JoHassel/Exo_UI/3D/Bilder/Explosionsansicht_MainUI.png

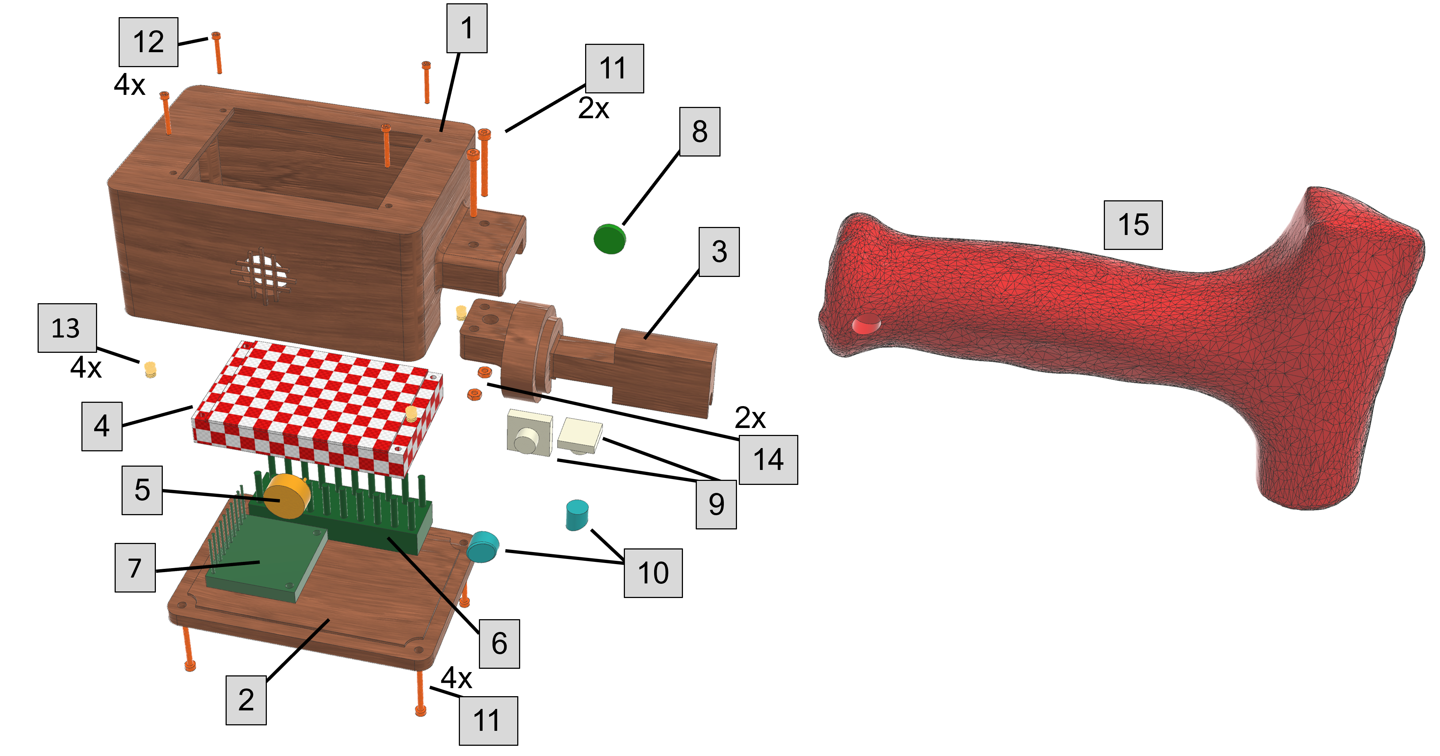
3D/Bilder/Explosionsansicht_MainUI.png
