JoHassel/Exo_UI/3D/Bilder/Konstruktion_real.jpeg

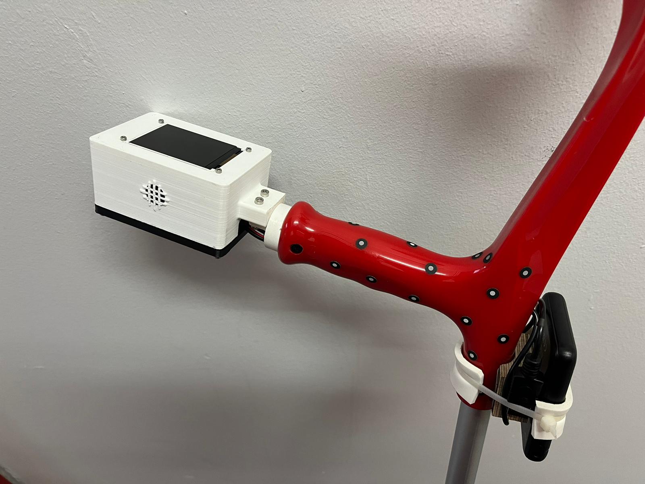
3D/Bilder/Konstruktion_real.jpeg
