JoHassel/Exo_UI/3D/Bilder/Kruecke_Hohlraum.jpeg

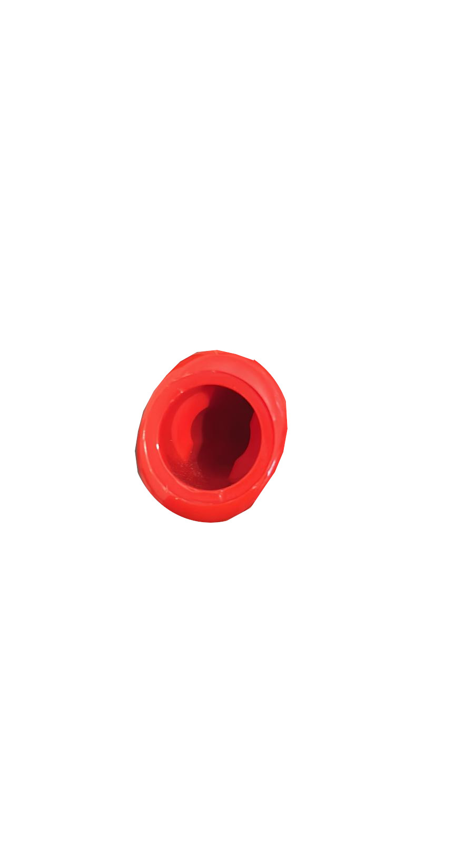
3D/Bilder/Kruecke_Hohlraum.jpeg
