JoHassel/Exo_UI/3D/Bilder/MainUI_Explosion.tif

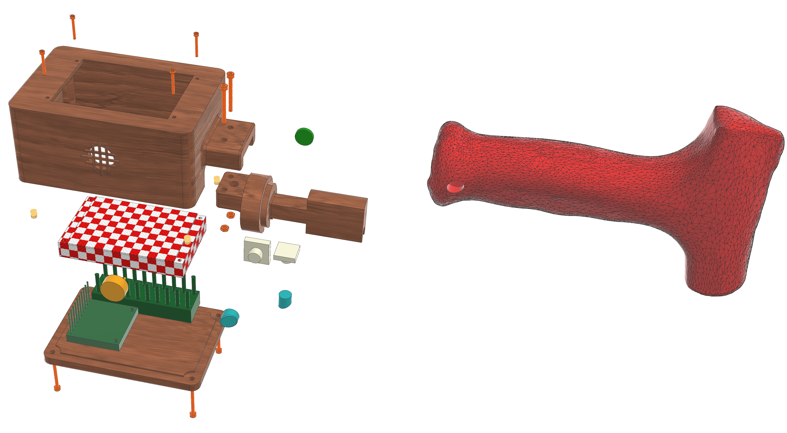
3D/Bilder/MainUI_Explosion.tif
