JoHassel/Exo_UI/3D/Bilder/MainUI_iso.png

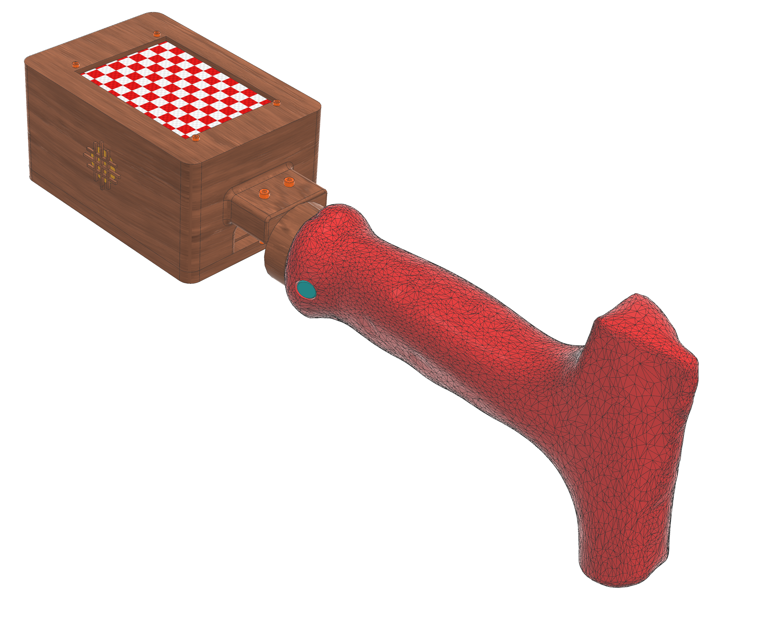
3D/Bilder/MainUI_iso.png
