JoHassel/Exo_UI/3D/Bilder/MainUI_Querschnitt.tif

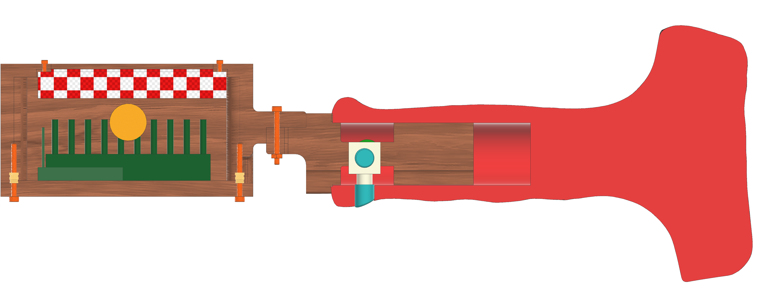
3D/Bilder/MainUI_Querschnitt.tif
