JoHassel/Exo_UI/3D/Bilder/SACU_Explosion.tif

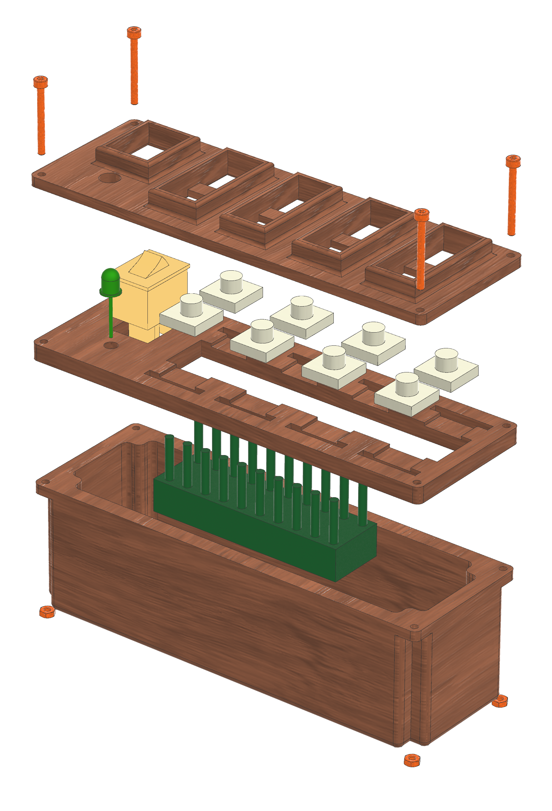
3D/Bilder/SACU_Explosion.tif
