JoHassel/Exo_UI/3D/Bilder/SACU_iso.tif

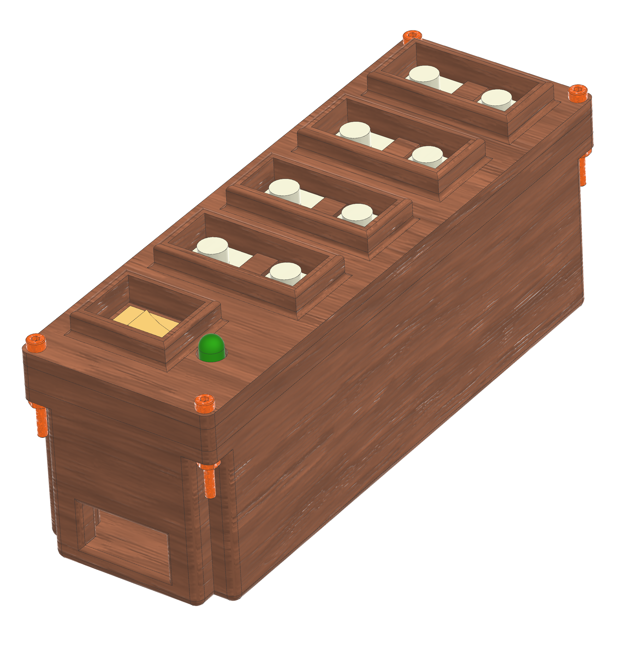
3D/Bilder/SACU_iso.tif
