JoHassel/Exo_UI/3D/Bilder/SACU_Querschnitt.tif

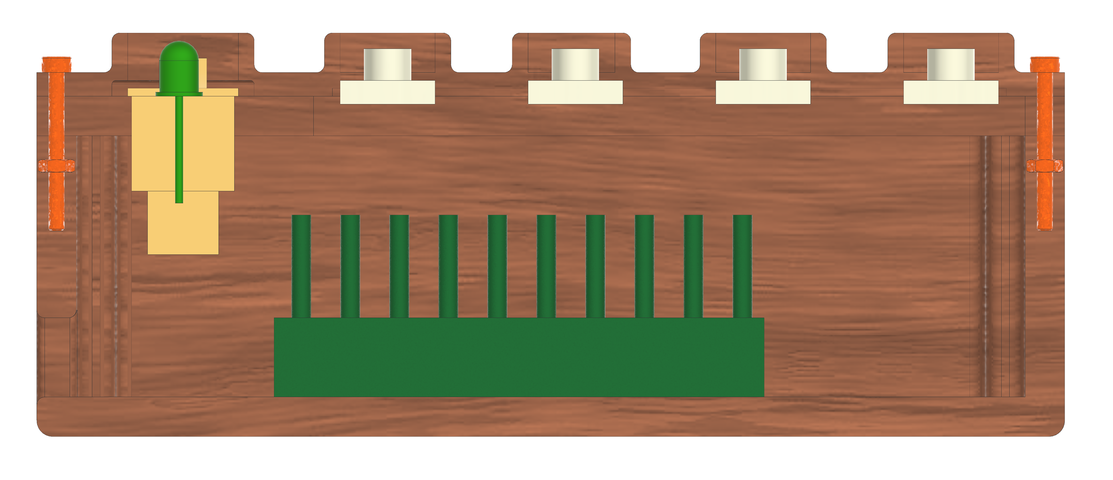
3D/Bilder/SACU_Querschnitt.tif
