JoHassel/Exo_UI/Code/Flow_Chart/PAP_MainUI_Aktiver_Status.png

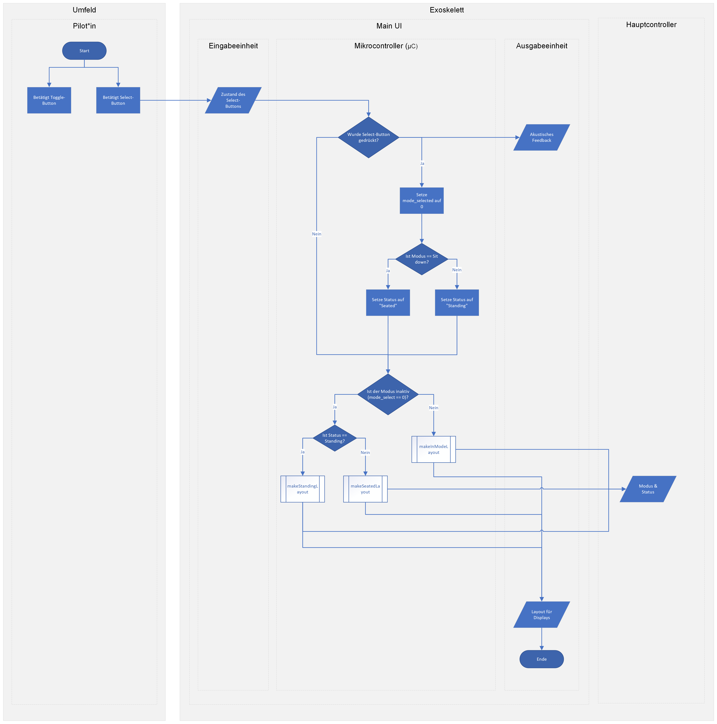
Code/Flow_Chart/PAP_MainUI_Aktiver_Status.png
