JoHassel/Exo_UI/Code/Flow_Chart/PAP_MainUI_Seated_Status.png

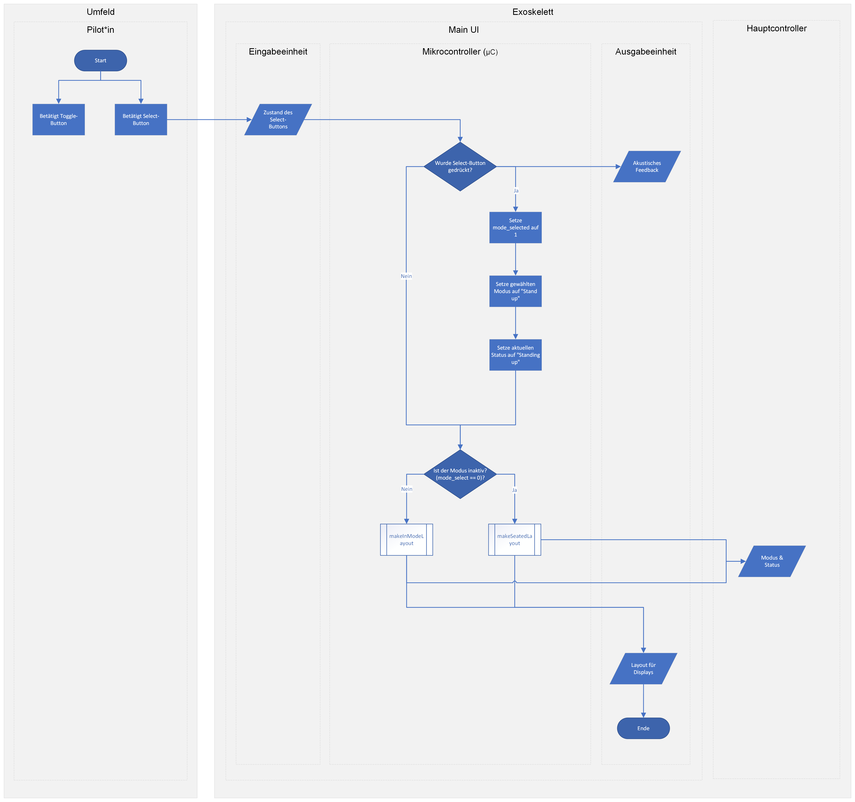
Code/Flow_Chart/PAP_MainUI_Seated_Status.png
