JoHassel/Exo_UI/Code/Flow_Chart/PAP_MainUI_Standing_Status.png

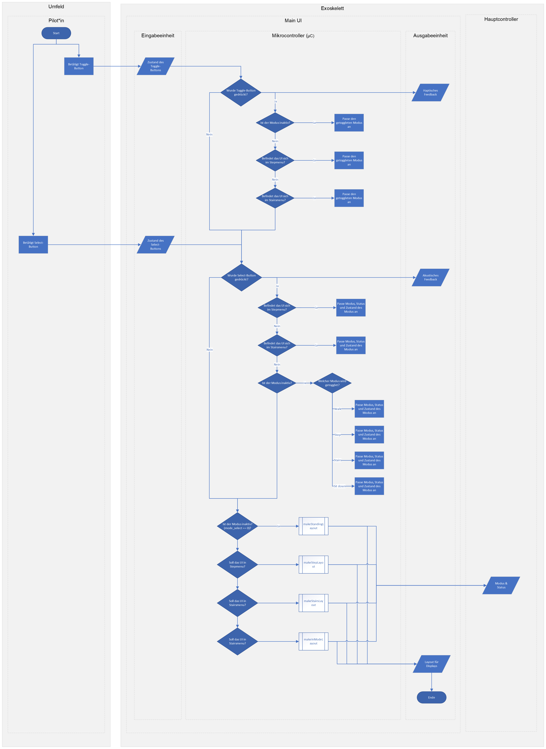
Code/Flow_Chart/PAP_MainUI_Standing_Status.png
