JoHassel/Exo_UI/Code/Flow_Chart/PAP_MainUI_Start.png

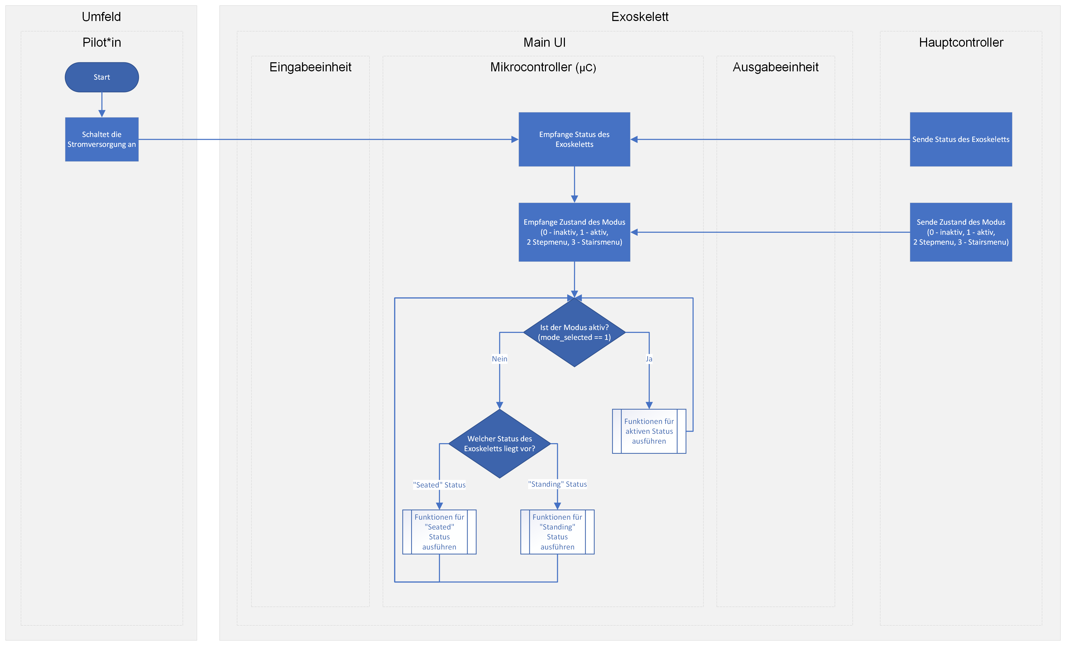
Code/Flow_Chart/PAP_MainUI_Start.png
