JoHassel/Exo_UI/Code/Flow_Chart/PAP_SACU.png

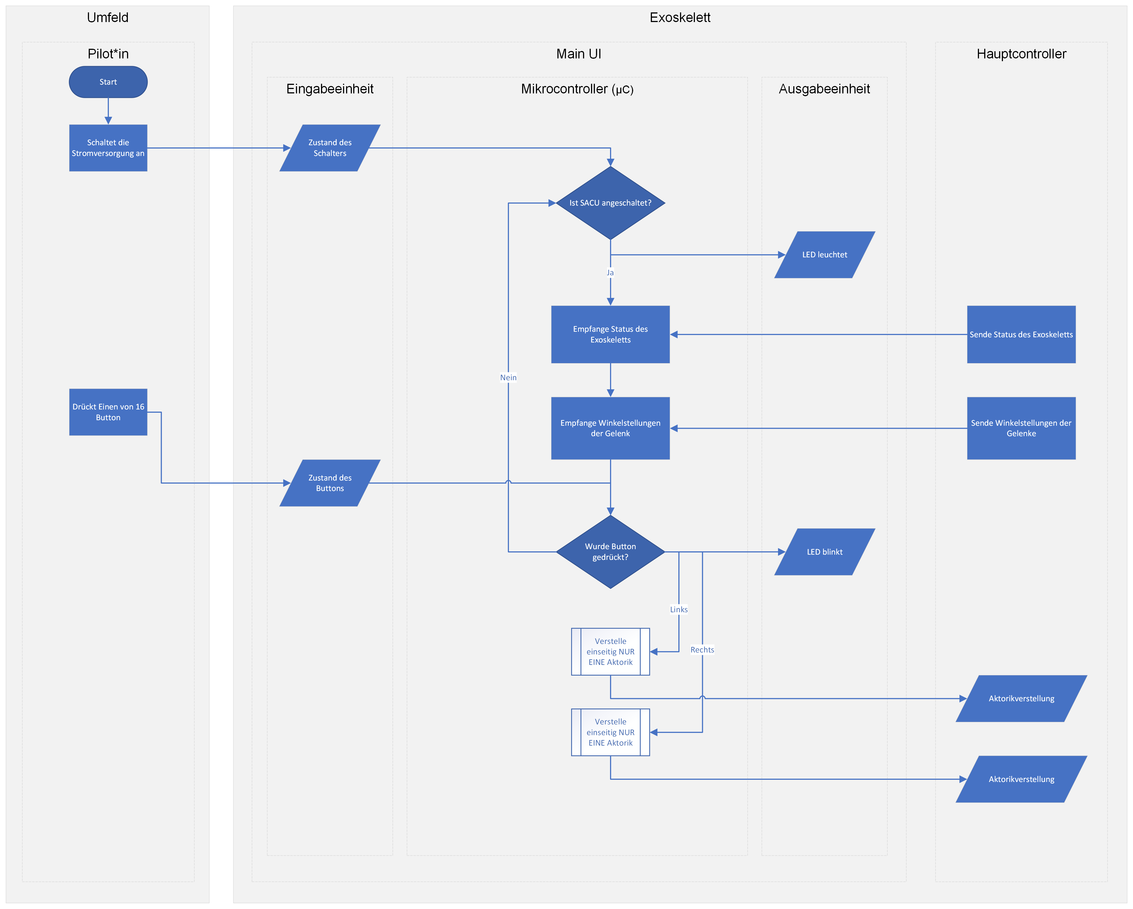
Code/Flow_Chart/PAP_SACU.png
