JoHassel/Exo_UI/EDA/Schaltplan_MAIN_UI_final.PNG

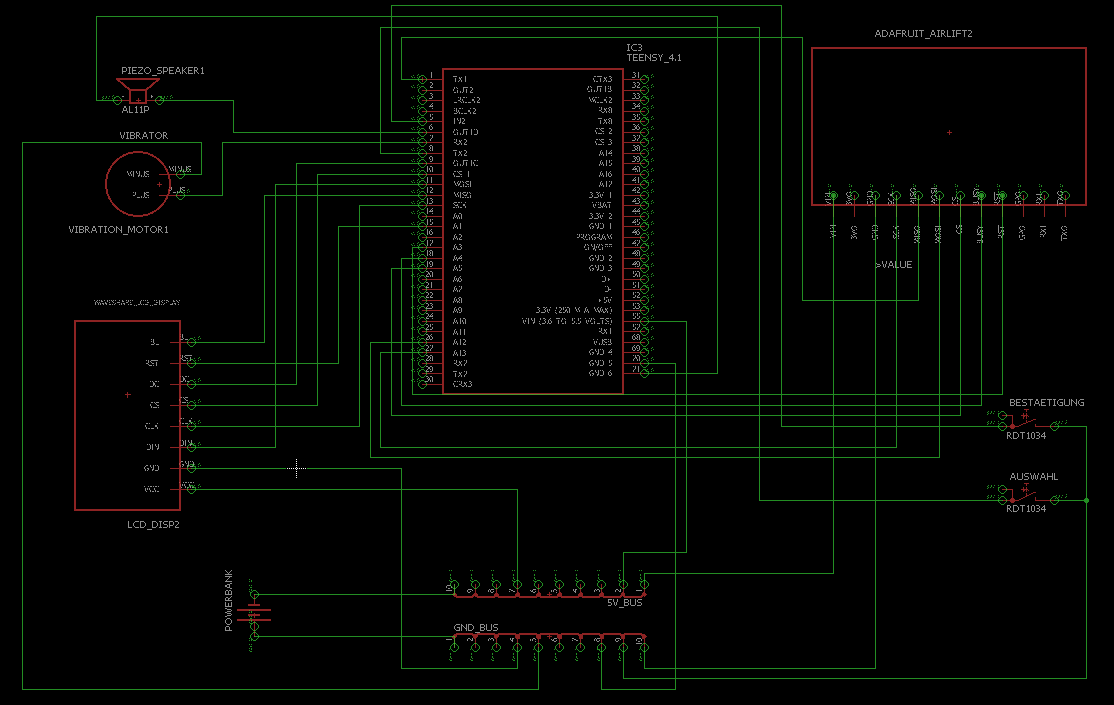
EDA/Schaltplan_MAIN_UI_final.PNG
