JoHassel/Exo_UI/EDA/Schaltplan_SACU_final.PNG

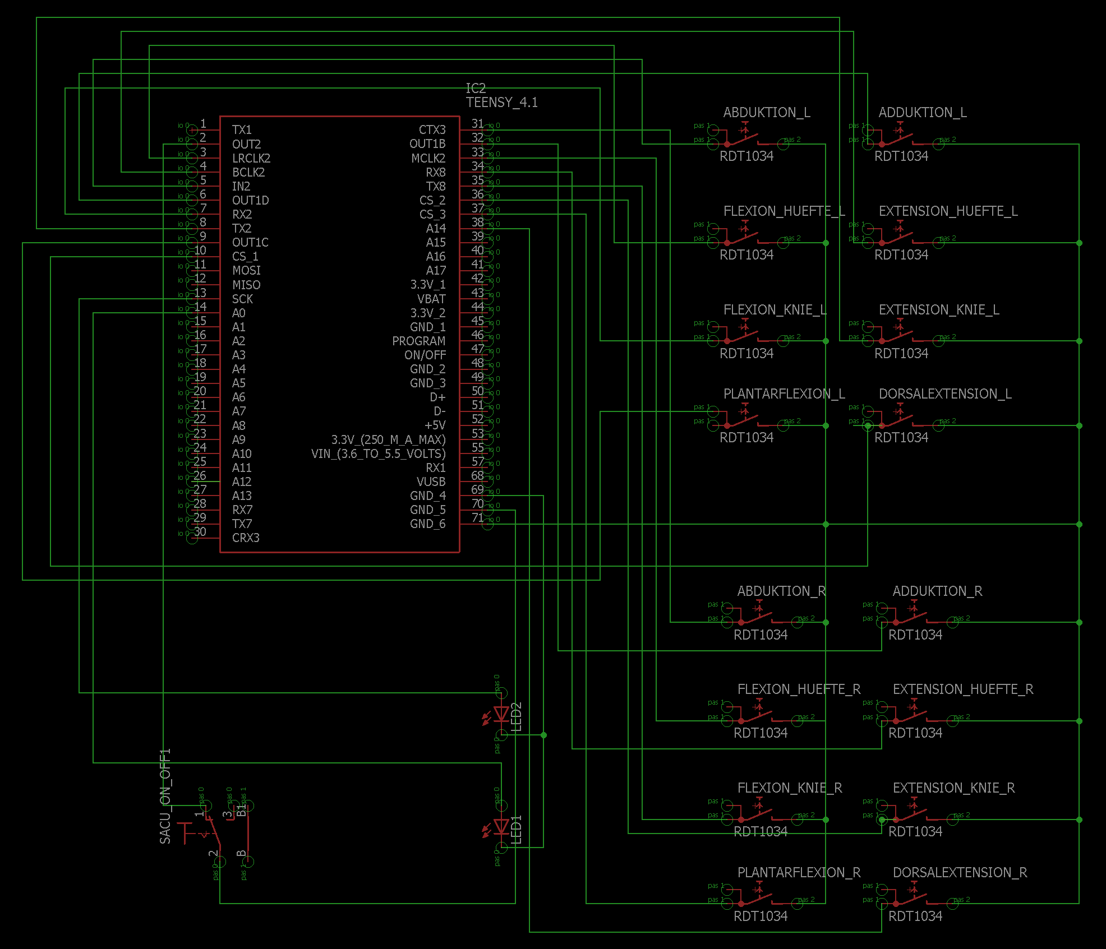
EDA/Schaltplan_SACU_final.PNG
