JoHassel/Exo_UI/(list of files, cad)

Other CAD files:
3D/button_schraeg2.prt
3D/din_912-m1_4x0_3-12-8_8_x_t.prt
3D/din_912-m2x0_4-20-8_8_x_t.prt
3D/din_en_iso_4032_m2x0_4_x_t.prt
3D/display_blackbox.prt
3D/gehaeuse1.prt
3D/gehaeuse2.prt
3D/gehaeuse_kruecke.prt
3D/parts_downloaded/din_912-m1_4x0_3-12-8_8.x_t
3D/parts_downloaded/din_912-m2x0_4-20-8_8.x_t
3D/parts_downloaded/din_en_iso_4032_m2x0_4.x_t
