JoHassel/Exo_UI/EDA/Schaltplan.sch

## EAGLE design EDA/Schaltplan.sch (2024-12-26)

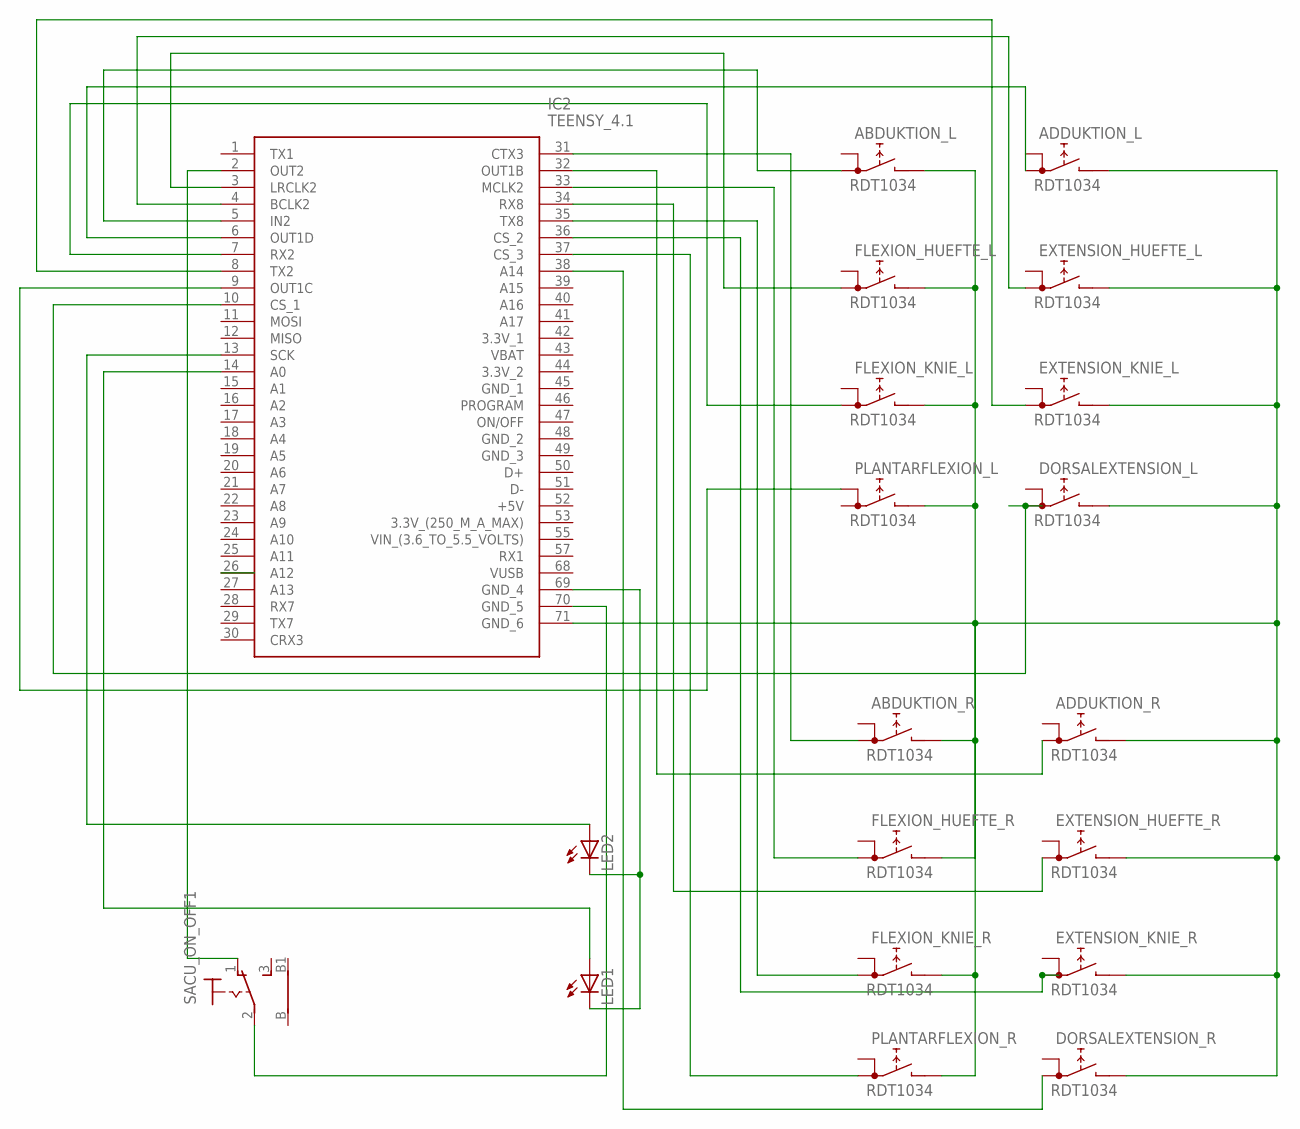
[picture p22: schematic Schaltplan.sch, sheet 1]

Parts:
ABDUKTION_L: RDT1034
ABDUKTION_R: RDT1034
ADDUKTION_L: RDT1034
ADDUKTION_R: RDT1034
DORSALEXTENSION_L: RDT1034
DORSALEXTENSION_R: RDT1034
EXTENSION_HUEFTE_L: RDT1034
EXTENSION_HUEFTE_R: RDT1034
EXTENSION_KNIE_L: RDT1034
EXTENSION_KNIE_R: RDT1034
FLEXION_HUEFTE_L: RDT1034
FLEXION_HUEFTE_R: RDT1034
FLEXION_KNIE_L: RDT1034
FLEXION_KNIE_R: RDT1034
IC2: TEENSY_4.1; TEENSY41
LED1, LED2: LED10MM
PLANTARFLEXION_L: RDT1034
PLANTARFLEXION_R: RDT1034
SACU_ON_OFF1: 316-917

Connections:
unnamed: ABDUKTION_L.B, ABDUKTION_R.B, ADDUKTION_L.B, ADDUKTION_R.B, DORSALEXTENSION_L.B, DORSALEXTENSION_R.B, EXTENSION_HUEFTE_L.B, EXTENSION_HUEFTE_R.B, EXTENSION_KNIE_L.B, EXTENSION_KNIE_R.B, FLEXION_HUEFTE_L.B, FLEXION_HUEFTE_R.B, FLEXION_KNIE_L.B, FLEXION_KNIE_R.B, IC2.71 (GND_6), PLANTARFLEXION_L.B, PLANTARFLEXION_R.B
unnamed: IC2.2 (OUT2), SACU_ON_OFF1.1 (O)
unnamed: EXTENSION_KNIE_R.A1, IC2.36 (CS_2)
unnamed: FLEXION_HUEFTE_L.A1, IC2.3 (LRCLK2)
unnamed: EXTENSION_HUEFTE_L.A1, IC2.4 (BCLK2)
unnamed: ABDUKTION_L.A1, IC2.5 (IN2)
unnamed: ADDUKTION_L.A1, IC2.6 (OUT1D)
unnamed: FLEXION_KNIE_L.A1, IC2.7 (RX2)
unnamed: EXTENSION_KNIE_L.A1, IC2.8 (TX2)
unnamed: IC2.9 (OUT1C), PLANTARFLEXION_L.A
unnamed: IC2.70 (GND_5), SACU_ON_OFF1.2
unnamed: IC2.13 (SCK), LED2.A
unnamed: IC2.69 (GND_4), LED1.K (C), LED2.K (C)
unnamed: ADDUKTION_R.A1, IC2.32 (OUT1B)
unnamed: IC2.14 (A0), LED1.A
unnamed: ABDUKTION_R.A1, IC2.31 (CTX3)
unnamed: FLEXION_HUEFTE_R.A1, IC2.33 (MCLK2)
unnamed: EXTENSION_HUEFTE_R.A1, IC2.34 (RX8)
unnamed: FLEXION_KNIE_R.A1, IC2.35 (TX8)
unnamed: IC2.37 (CS_3), PLANTARFLEXION_R.A1
unnamed: DORSALEXTENSION_R.A1, IC2.38 (A14)

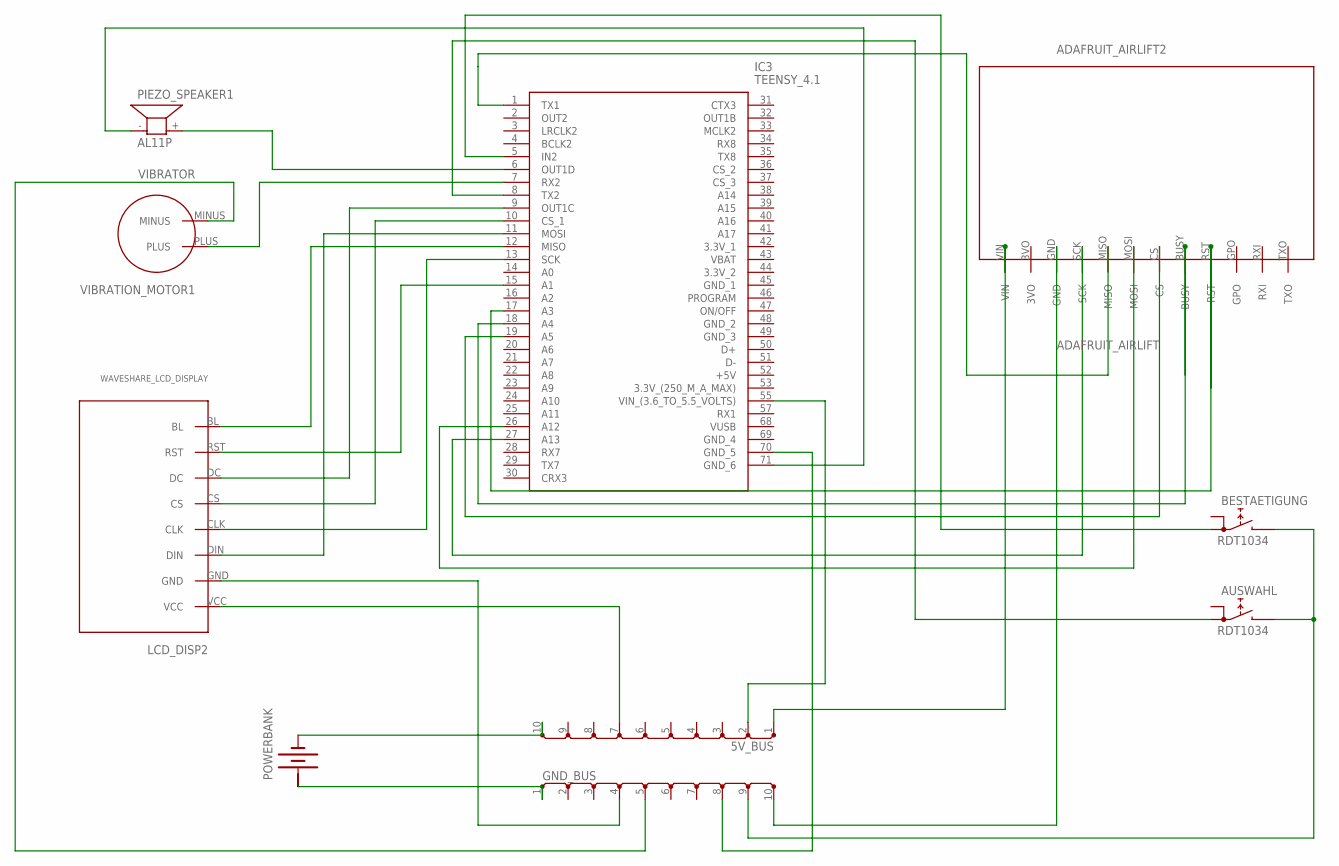
[picture p23: schematic Schaltplan.sch, sheet 2]

Parts:
5V_BUS: TE4/10
ADAFRUIT_AIRLIFT2: ADAFRUIT_AIRLIFT
AUSWAHL: RDT1034
BESTAETIGUNG: RDT1034
GND_BUS: TE4/10
IC3: TEENSY_4.1; TEENSY41
LCD_DISP2: WAVESHARE_LCD_DISPLAY
PIEZO_SPEAKER1: AL11P
POWERBANK: BATTERY
VIBRATION_MOTOR1: VIBRATOR

Connections:
5V: 5V_BUS.2, IC3.55 (VIN_(3.6_TO_5.5_VOLTS))
GND: GND_BUS.4, LCD_DISP2.GND
unnamed: 5V_BUS.7, LCD_DISP2.VCC
unnamed: ADAFRUIT_AIRLIFT2.CS, IC3.19 (A5)
unnamed: IC3.15 (A1), LCD_DISP2.RST
unnamed: ADAFRUIT_AIRLIFT2.BUSY, IC3.18 (A4)
unnamed: ADAFRUIT_AIRLIFT2.RST, IC3.17 (A3)
unnamed: IC3.71 (GND_6), PIEZO_SPEAKER1.- (1)
unnamed: IC3.10 (CS_1), LCD_DISP2.CS
unnamed: 5V_BUS.1, ADAFRUIT_AIRLIFT2.VIN
unnamed: IC3.9 (OUT1C), LCD_DISP2.DC
unnamed: IC3.13 (SCK), LCD_DISP2.CLK
unnamed: ADAFRUIT_AIRLIFT2.GND, GND_BUS.10
unnamed: IC3.11 (MOSI), LCD_DISP2.DIN
unnamed: IC3.12 (MISO), LCD_DISP2.BL
unnamed: GND_BUS.5, VIBRATION_MOTOR1.MINUS
unnamed: IC3.7 (RX2), VIBRATION_MOTOR1.PLUS
unnamed: IC3.6 (OUT1D), PIEZO_SPEAKER1.+ (2)
unnamed: AUSWAHL.A1, IC3.8 (TX2)
unnamed: BESTAETIGUNG.A1, IC3.5 (IN2)
unnamed: AUSWAHL.B, BESTAETIGUNG.B, GND_BUS.9
unnamed: ADAFRUIT_AIRLIFT2.SCK, IC3.27 (A13)
unnamed: ADAFRUIT_AIRLIFT2.MOSI, IC3.26 (A12)
unnamed: ADAFRUIT_AIRLIFT2.MISO, IC3.1 (TX1)
unnamed: GND_BUS.8, IC3.70 (GND_5)
unnamed: 5V_BUS.10, POWERBANK.-
unnamed: GND_BUS.1, POWERBANK.+
